cmfrancis/BIGLEDClock/images/001.jpg

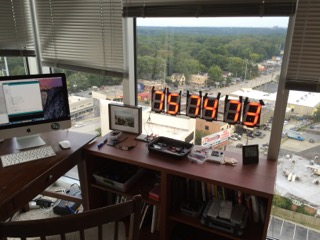
images/001.jpg
