cmfrancis/BIGLEDClock/images/002.jpg

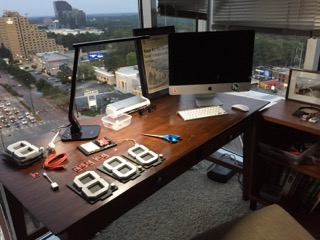
images/002.jpg
