cmfrancis/BIGLEDClock/images/003.jpg

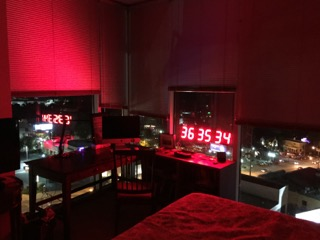
images/003.jpg
