cmfrancis/BIGLEDClock/images/004.jpg

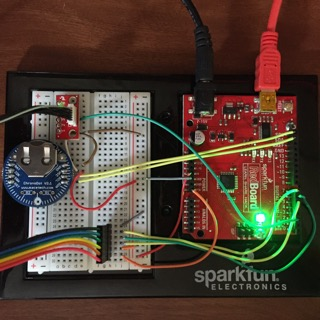
images/004.jpg
