cmfrancis/BIGLEDClock/images/005.jpg

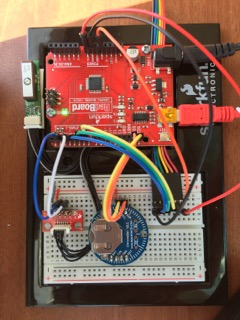
images/005.jpg
