cmfrancis/BIGLEDClock/images/007.jpg

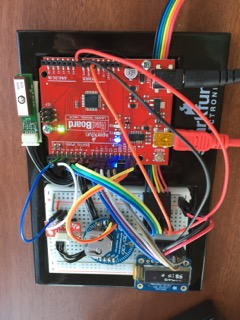
images/007.jpg
