cmfrancis/BIGLEDClock/images/008.jpg

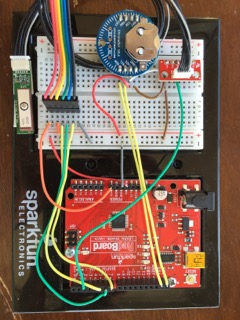
images/008.jpg
