cmfrancis/BIGLEDClock/images/009.jpg

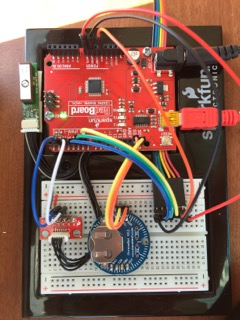
images/009.jpg
