cmfrancis/BIGLEDClock/images/010.jpg

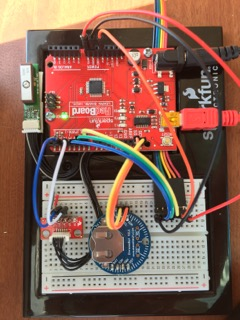
images/010.jpg
