cmfrancis/BIGLEDClock/images/012.jpg

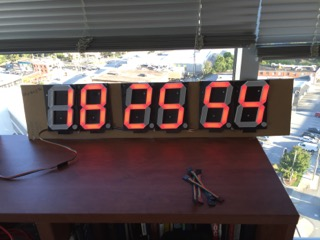
images/012.jpg
