cmfrancis/BIGLEDClock/images/013.jpg

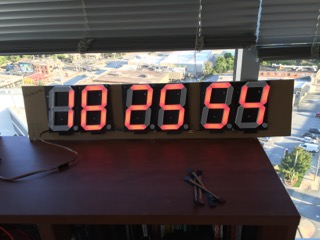
images/013.jpg
