cmfrancis/BIGLEDClock/images/014.jpg

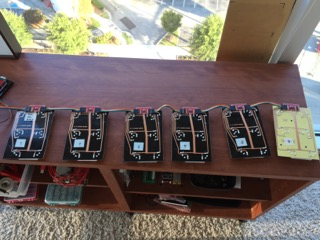
images/014.jpg
