cmfrancis/BIGLEDClock/images/016.jpg

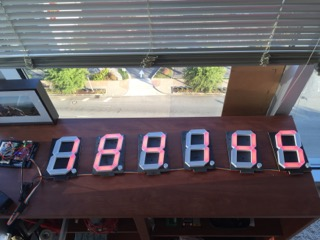
images/016.jpg
