cmfrancis/BIGLEDClock/images/017.jpg

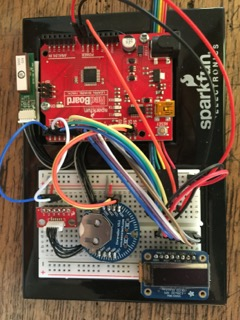
images/017.jpg
