cmfrancis/BIGLEDClock/images/018.jpg

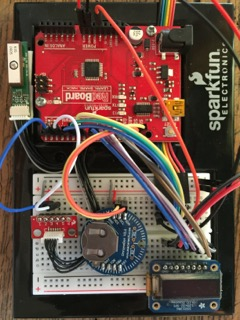
images/018.jpg
