cmfrancis/BIGLEDClock/images/BIGLEDClockBOM.png

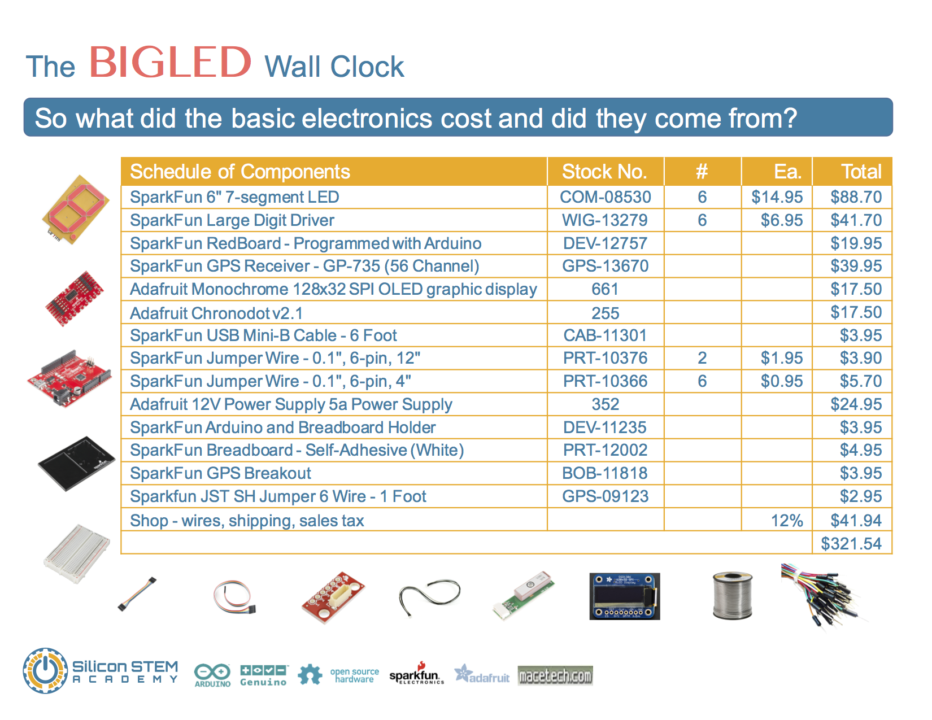
images/BIGLEDClockBOM.png
