cmfrancis/BIGLEDClock/docs/ChronoDotV2a.pdf

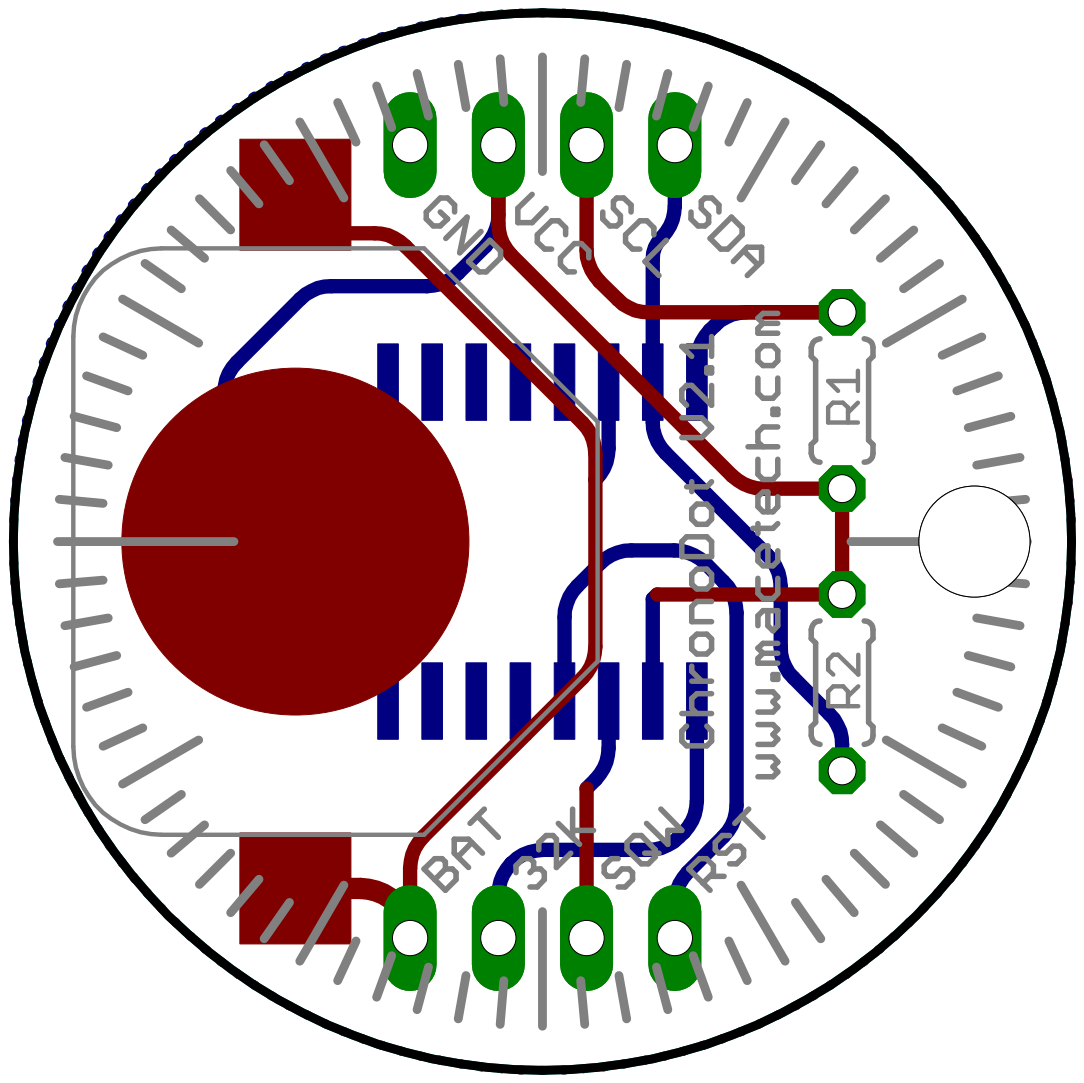
[picture p26: page 1]
