cmfrancis/BIGLEDClock/docs/BigLEDWallClockDiagrams.pdf

22 in

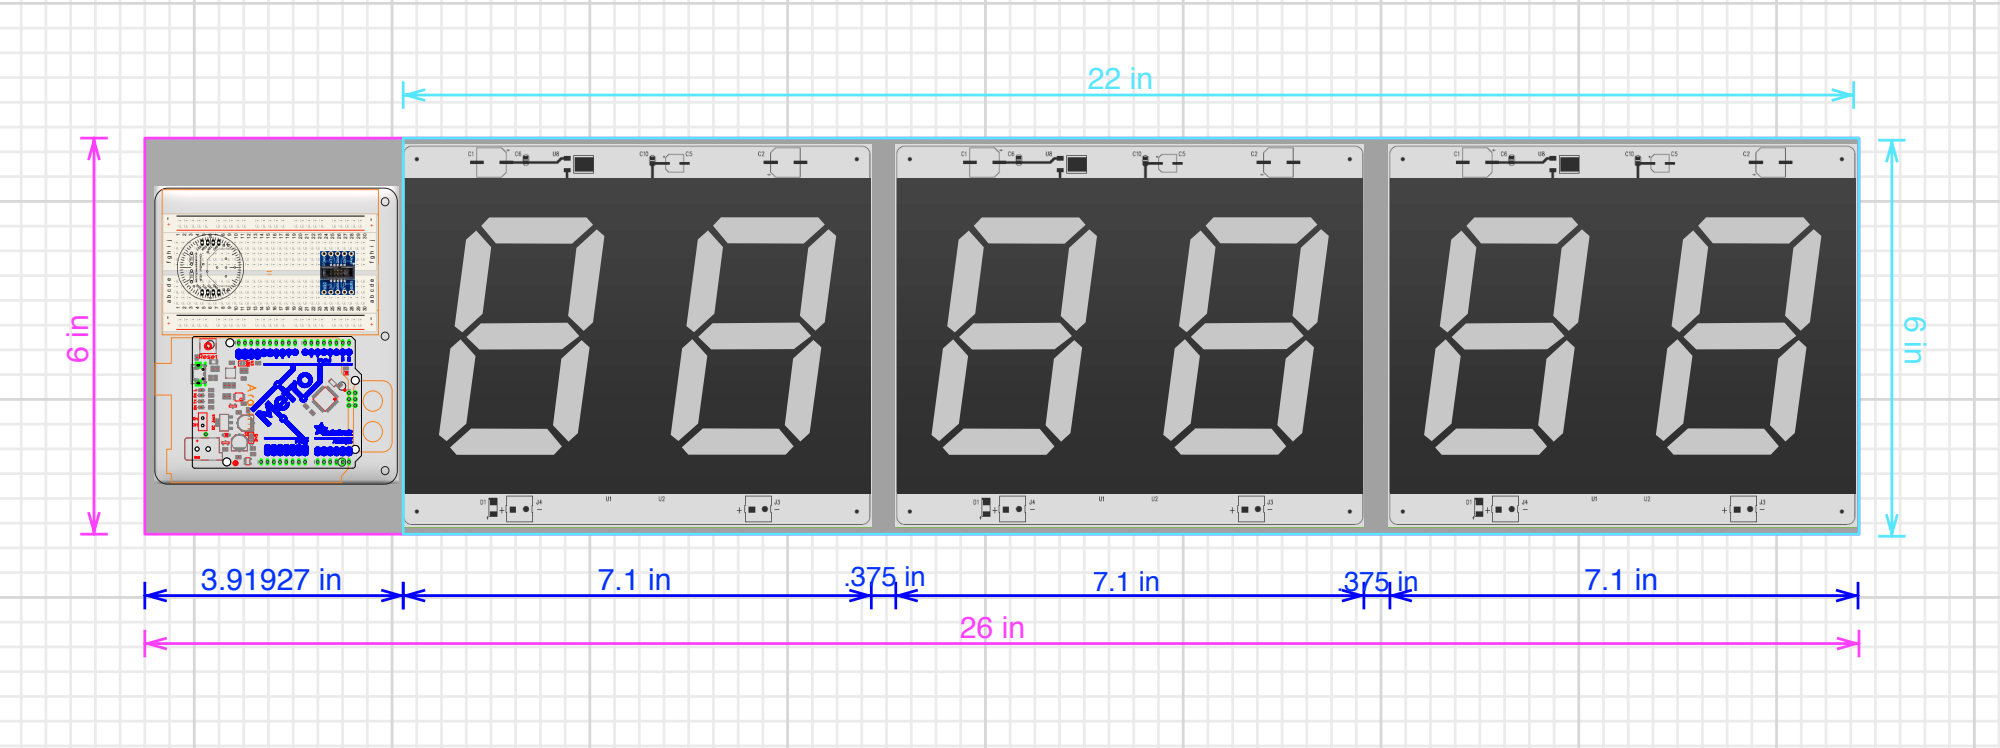
[picture p23: page 1]
Breadboard; Arduino
